innif/Arduino-Game-System/GameSystem/GameSystem.ino

// GameSystem.ino - Hauptdatei
#include "config.h"
#include "display.h"
#include "input.h"
#include "gamemanager.h"
#include "highscore.h"

void setup() {
  Serial.begin(115200);
  initDisplay();
  initInput();
  initHighscores();
  initGameManager();
}

void loop() {
  updateInput();
  updateGameManager();
  delay(16); // ~60 FPS
}
