innif/Arduino-Game-System/GameSystem/input.h

#ifndef INPUT_H
#define INPUT_H

#include "config.h"

struct ButtonState {
  bool up;
  bool down;
  bool left;
  bool right;
  bool upPressed;
  bool downPressed;
  bool leftPressed;
  bool rightPressed;
};

extern ButtonState buttons;
extern unsigned long lastButtonTime;

void initInput();
void updateInput();
bool isButtonPressed(int pin);
bool wasButtonJustPressed(int pin);

#endif
