innif/Arduino-Game-System/(commit log)

2025-06-11 Frogger Live Count fix
    [frogger.cpp]
2025-06-12 Added Assembly Instructions
2025-06-13 Added images in assembly
